blafr103/poolChlorinator/images/prototype1_circuit.png

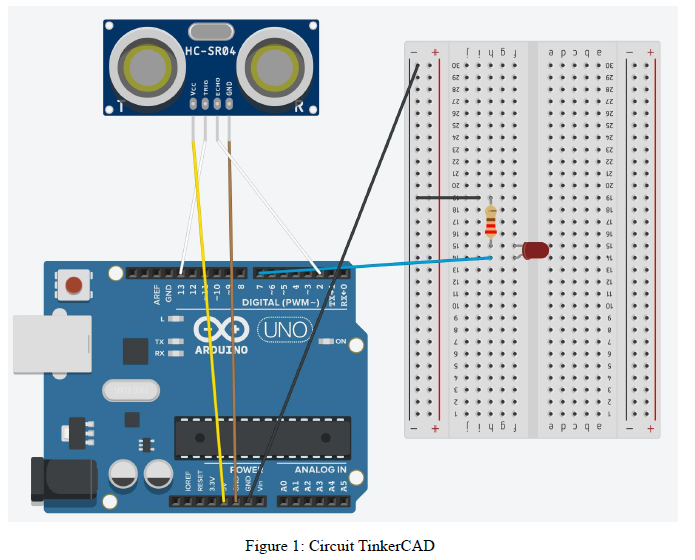
images/prototype1_circuit.png
