blafr103/poolChlorinator/images/prototype2_full.png

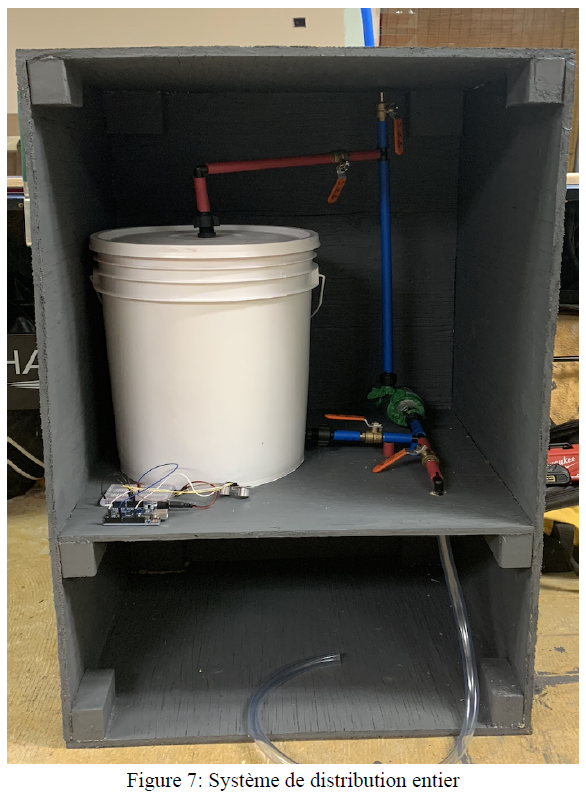
images/prototype2_full.png
