blafr103/poolChlorinator/images/code_flowchart.png

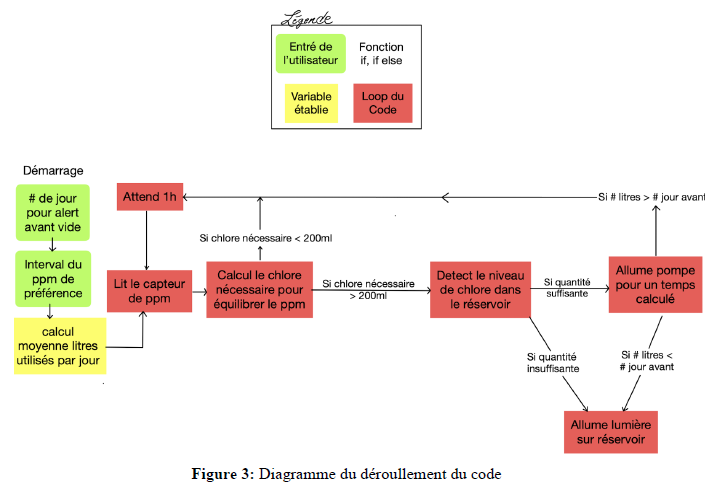
images/code_flowchart.png
