blafr103/poolChlorinator/docs/GNG2501 - Journée de conception.pdf

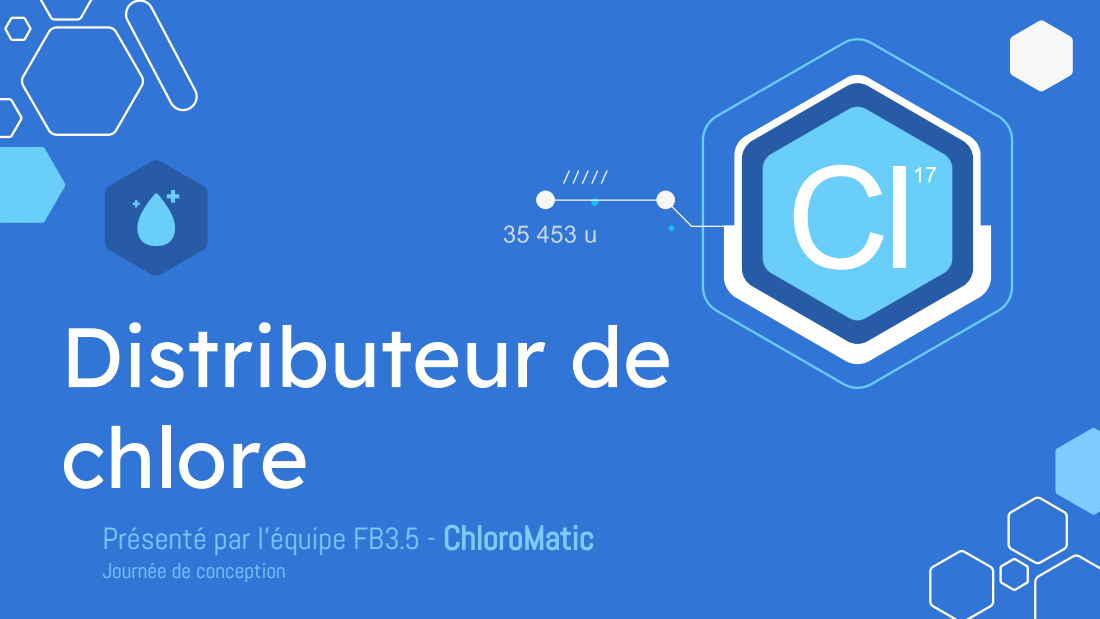
[picture p32: page 1]
Distributeur de chlore

Présenté par l’équipe FB3.5 - ChloroMatic
Journée de conception

# Agenda

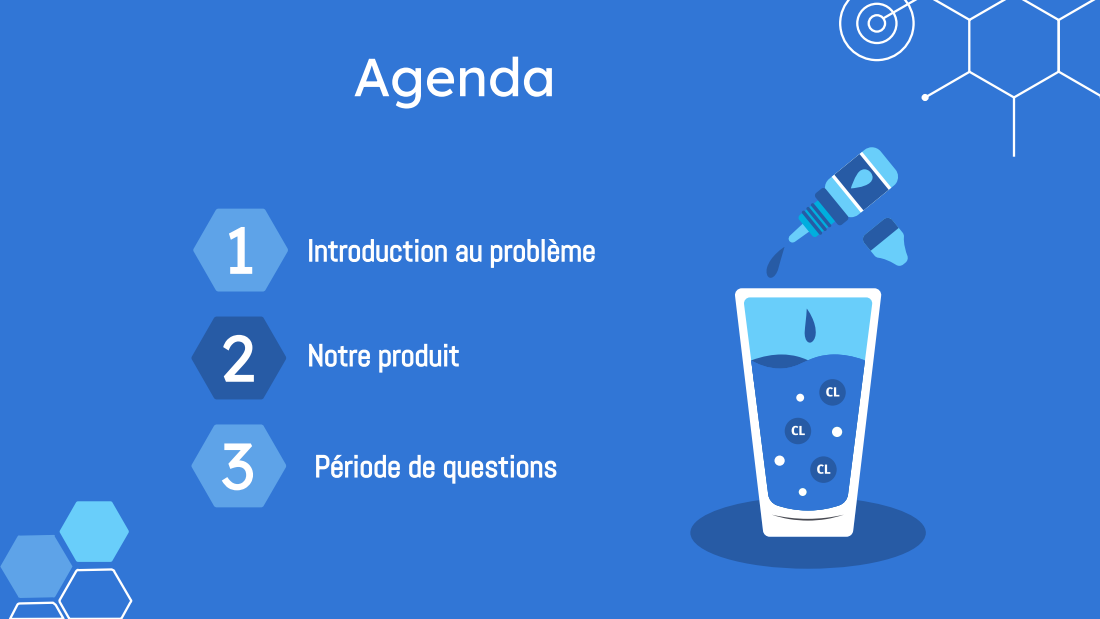
[picture p33: page 2]
Période de questions; Notre produit; Introduction au problème

# Introduction au problème

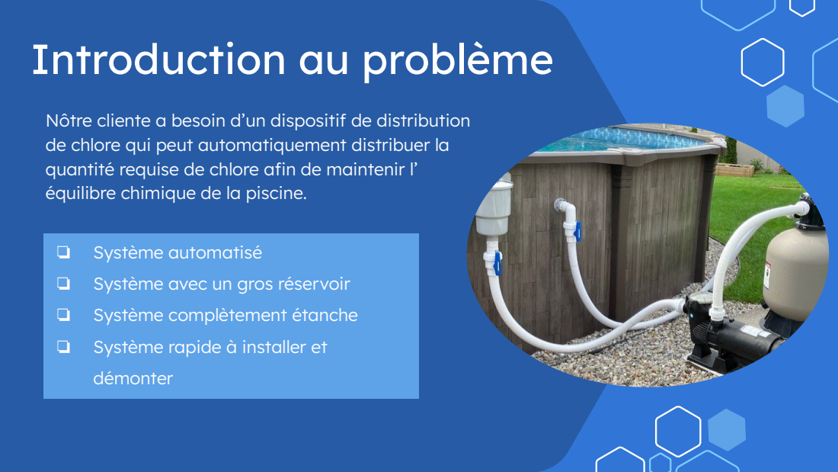
[picture p34: page 3]
Système automatisé; Système avec un gros réservoir; Système complètement étanche; Système rapide à installer et; démonter

Nôtre cliente a besoin d’un dispositif de distribution
de chlore qui peut automatiquement distribuer la
quantité requise de chlore afin de maintenir l’
équilibre chimique de la piscine.

# Conception et Évolution

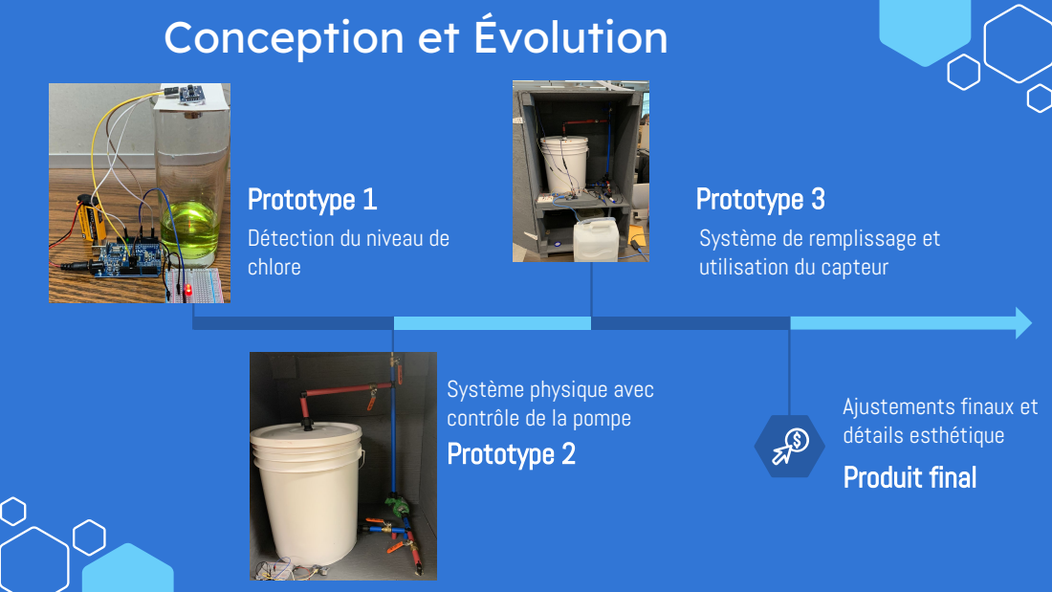
[picture p35: page 4]
contrôle de la pompe; Ajustements finaux et; détails esthétique; Prototype 1; Prototype 3; Produit final

Détection du niveau de
chlore

Système de remplissage et
utilisation du capteur

Système physique avec
Prototype 2

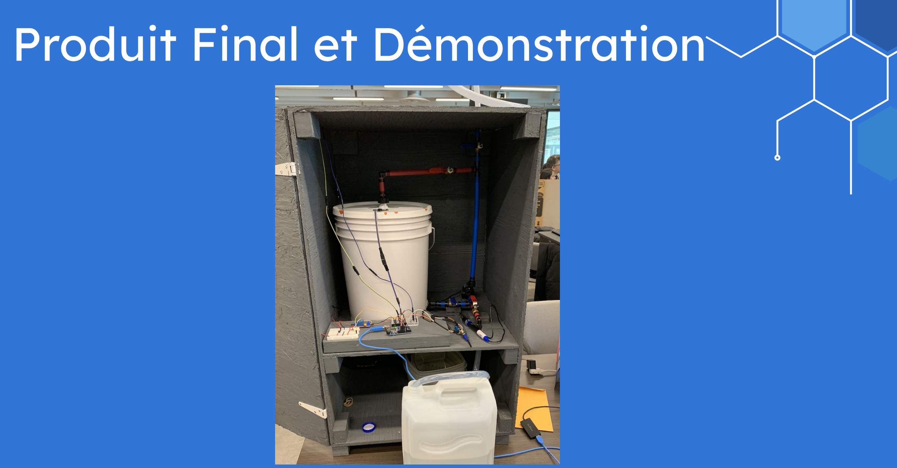
[picture p36: figure]
Produit Final et Démonstration
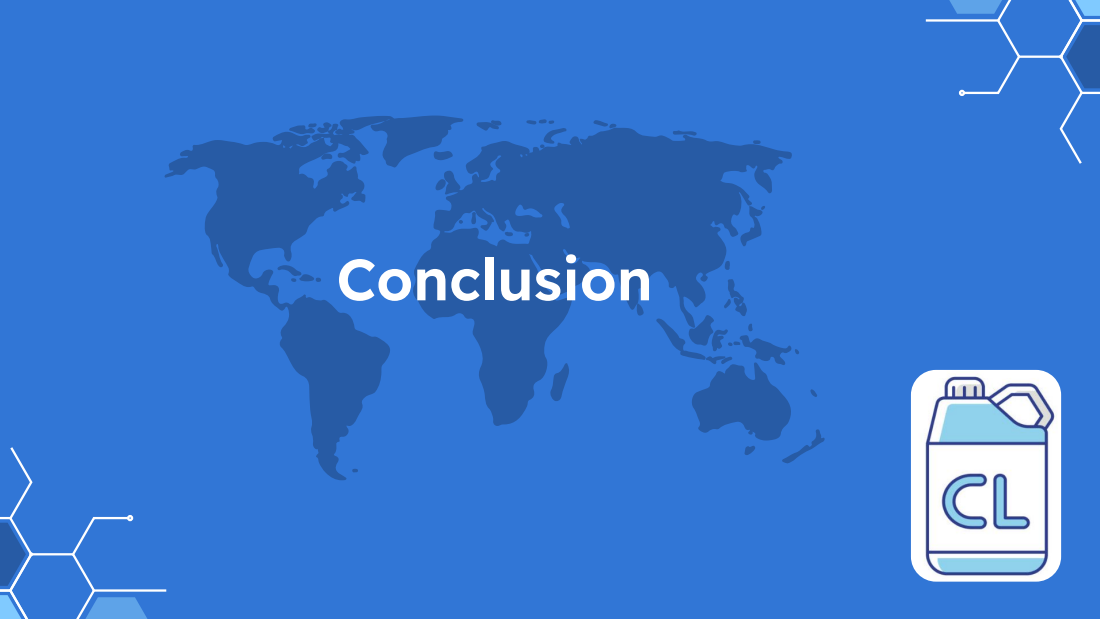
[picture p37: page 6]
Conclusion

## Pourquoi choisir ? Notre produit

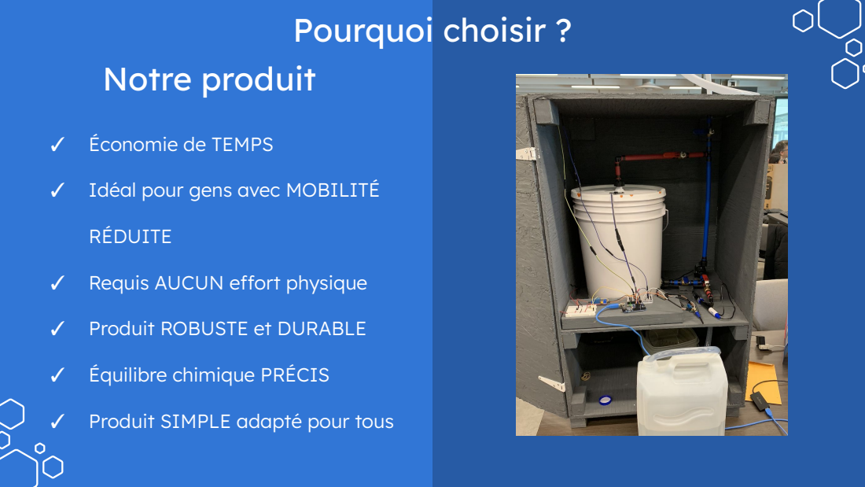
[picture p38: page 7]
RÉDUITE

✓ Économie de TEMPS

✓ Idéal pour gens avec MOBILITÉ

✓ Requis AUCUN effort physique

✓ Produit ROBUSTE et DURABLE

✓ Équilibre chimique PRÉCIS

✓ Produit SIMPLE adapté pour tous

## Pourquoi choisir ? Notre équipe

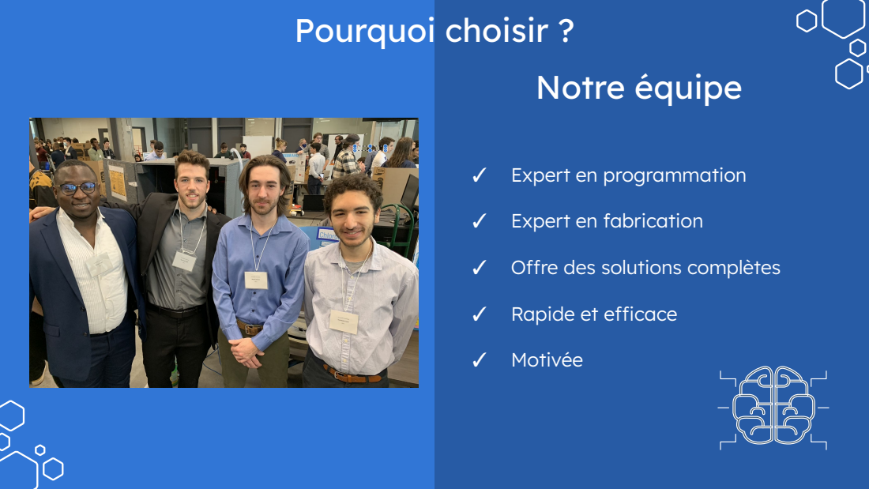
[picture p39: page 8]
✓ Motivée

✓ Expert en programmation

✓ Expert en fabrication

✓ Offre des solutions complètes

✓ Rapide et efficace

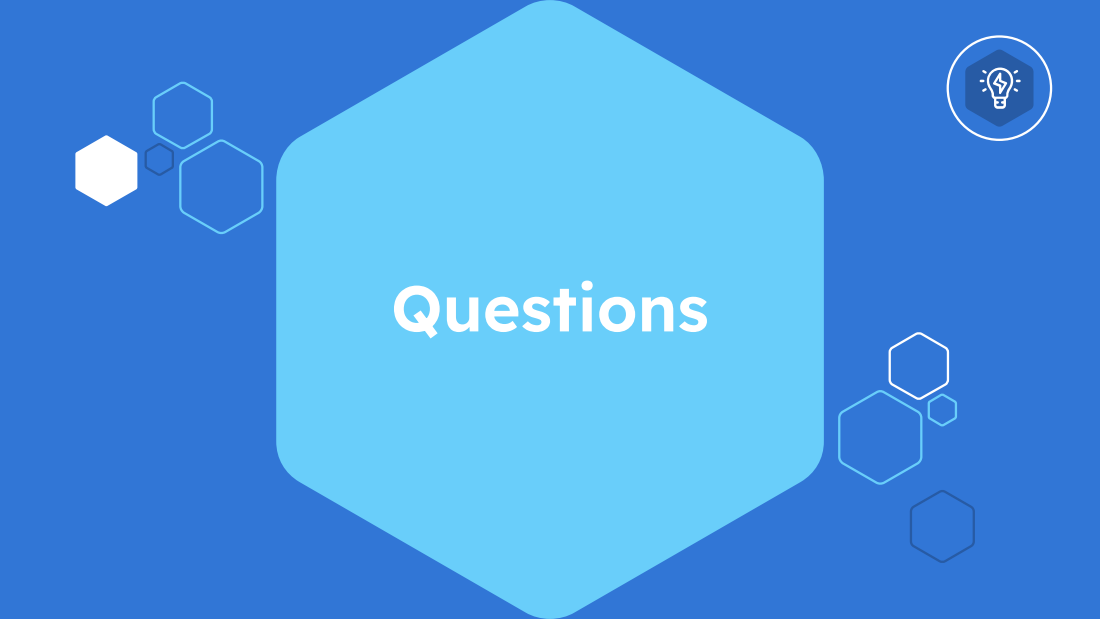
[picture p40: page 9]
Questions

# Besoins interprétés

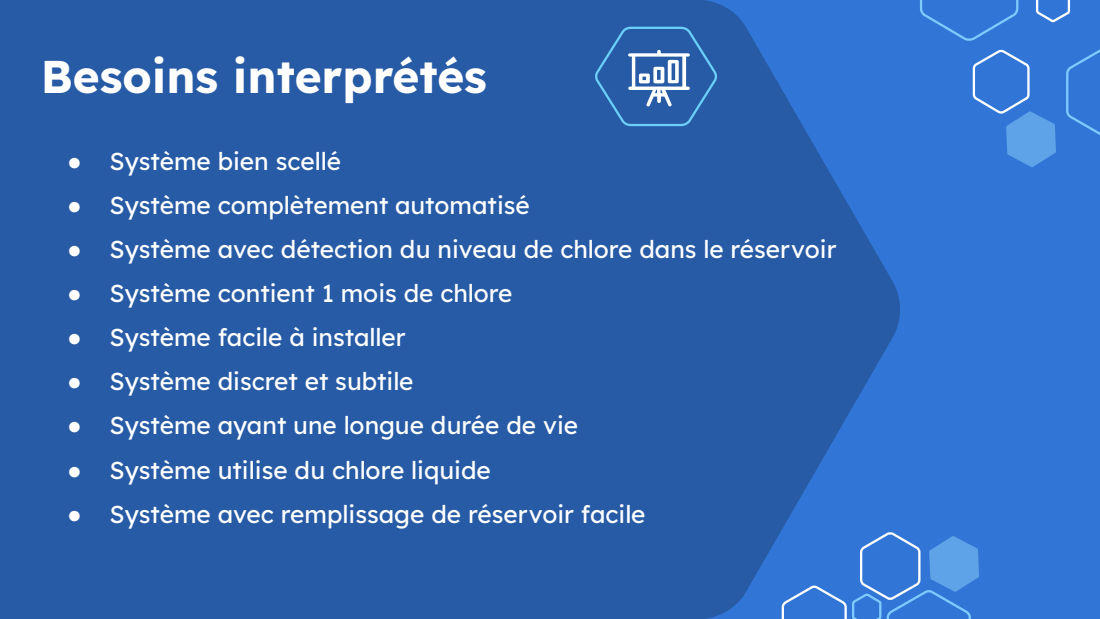
[picture p41: page 10]

● Système bien scellé
● Système complètement automatisé
● Système avec détection du niveau de chlore dans le réservoir
● Système contient 1 mois de chlore
● Système facile à installer
● Système discret et subtile
● Système ayant une longue durée de vie
● Système utilise du chlore liquide
● Système avec remplissage de réservoir facile

# Liste des Métriques

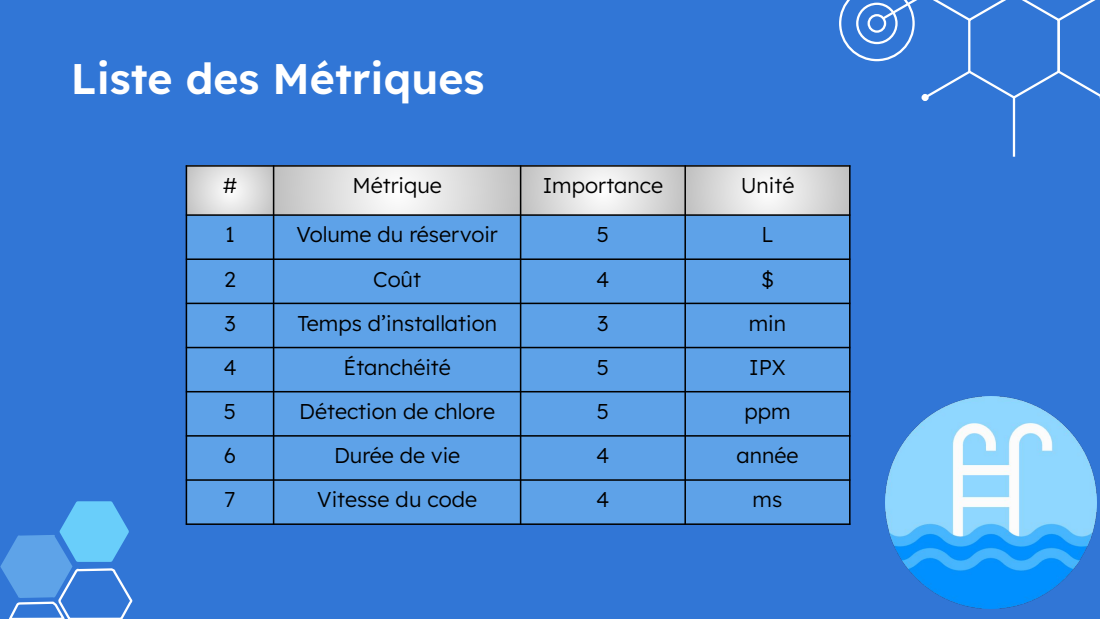
[picture p42: page 11]

# | Métrique | Importance | Unité
1 | Volume du réservoir | 5 | L
2 | Coût | 4 | $
3 | Temps d’installation | 3 | min
4 | Étanchéité | 5 | IPX
5 | Détection de chlore | 5 | ppm
6 | Durée de vie | 4 | année
7 | Vitesse du code | 4 | ms

# Étalonnage avec la concurrence

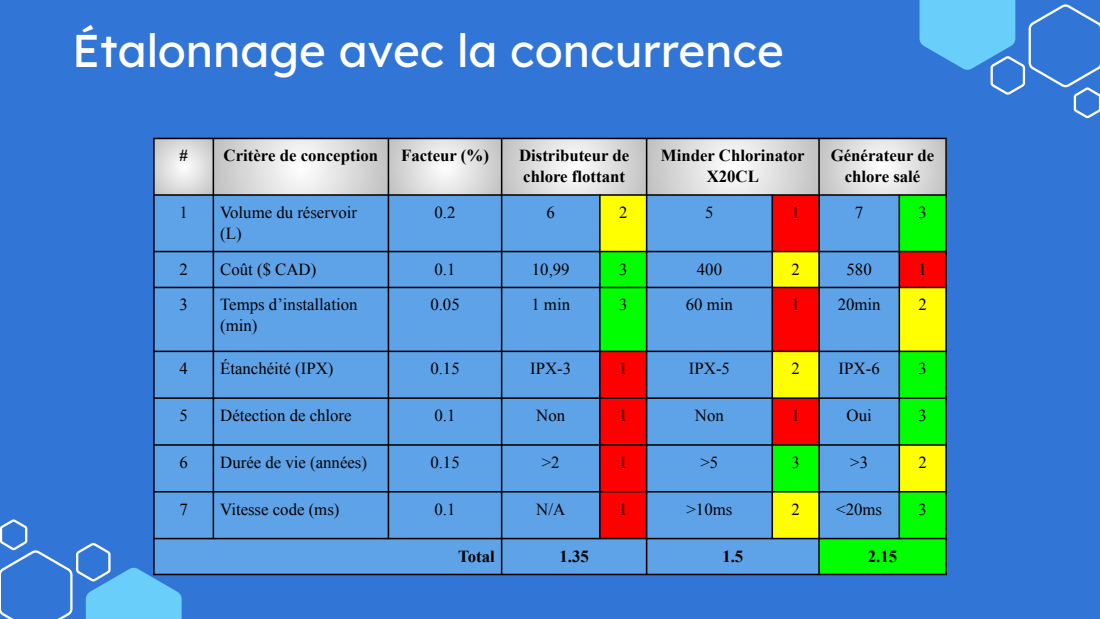
[picture p43: page 12]

# | Critère de conception | Facteur (%) | Distributeur de chlore flottant | Minder Chlorinator X20CL | Générateur de chlore salé

1 | Volume du réservoir (L) | 0.2 | 6 | 2 | 5 | 1 | 7 | 3

2 | Coût ($ CAD) | 0.1 | 10,99 | 3 | 400 | 2 | 580 | 1

3 | Temps d’installation (min) | 0.05 | 1 min | 3 | 60 min | 1 | 20min | 2

4 | Étanchéité (IPX) | 0.15 | IPX-3 | 1 | IPX-5 | 2 | IPX-6 | 3

5 | Détection de chlore | 0.1 | Non | 1 | Non | 1 | Oui | 3

6 | Durée de vie (années) | 0.15 | >2 | 1 | >5 | 3 | >3 | 2

7 | Vitesse code (ms) | 0.1 | N/A | 1 | >10ms | 2 | <20ms | 3

Total | | | 1.35 | | 1.5 | | 2.15

# Spécifications cibles

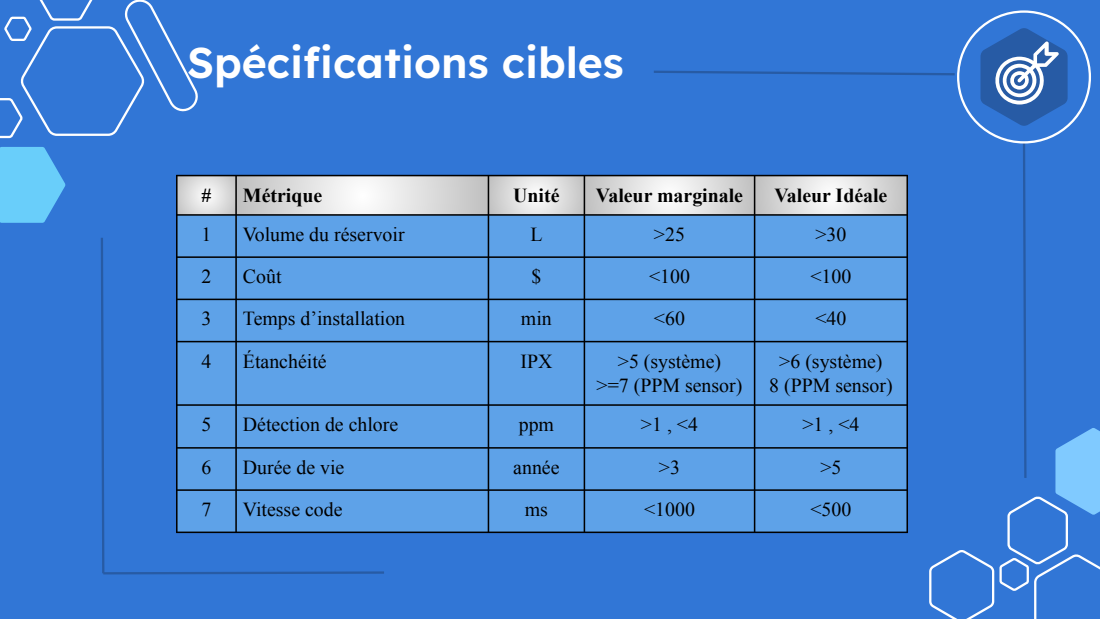
[picture p44: page 13]

# | Métrique | Unité | Valeur marginale | Valeur Idéale

1 | Volume du réservoir | L | >25 | >30

2 | Coût | $ | <100 | <100

3 | Temps d’installation | min | <60 | <40

4 | Étanchéité | IPX | >5 (système) >=7 (PPM sensor) | >6 (système) 8 (PPM sensor)

5 | Détection de chlore | ppm | >1 , <4 | >1 , <4

6 | Durée de vie | année | >3 | >5

7 | Vitesse code | ms | <1000 | <500

## Système logiciel

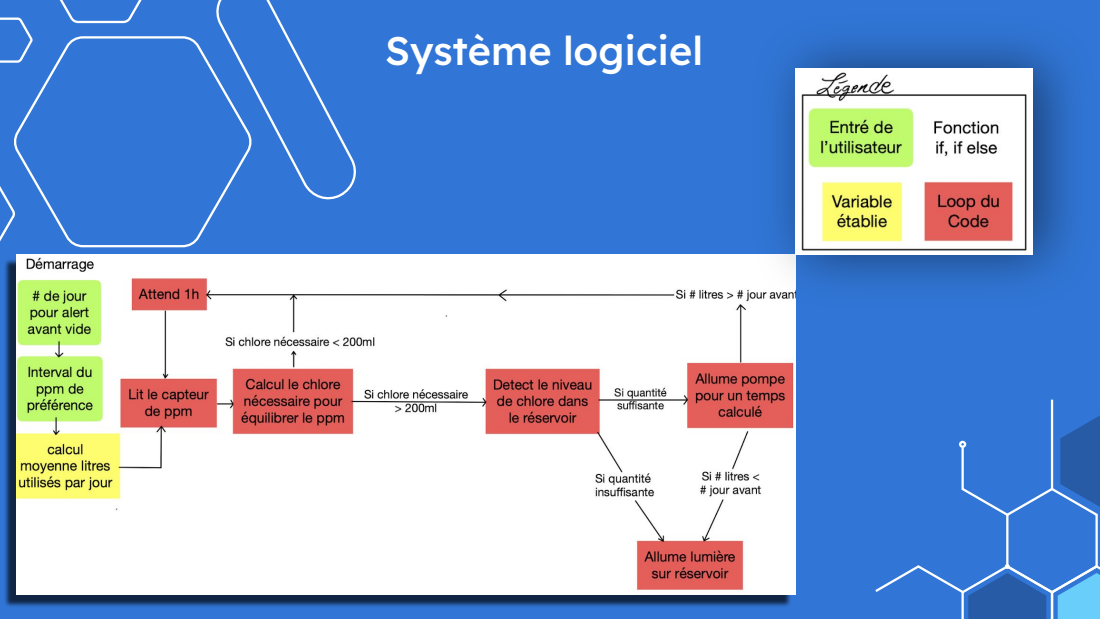
[picture p45: page 14]

# Rétroaction du client

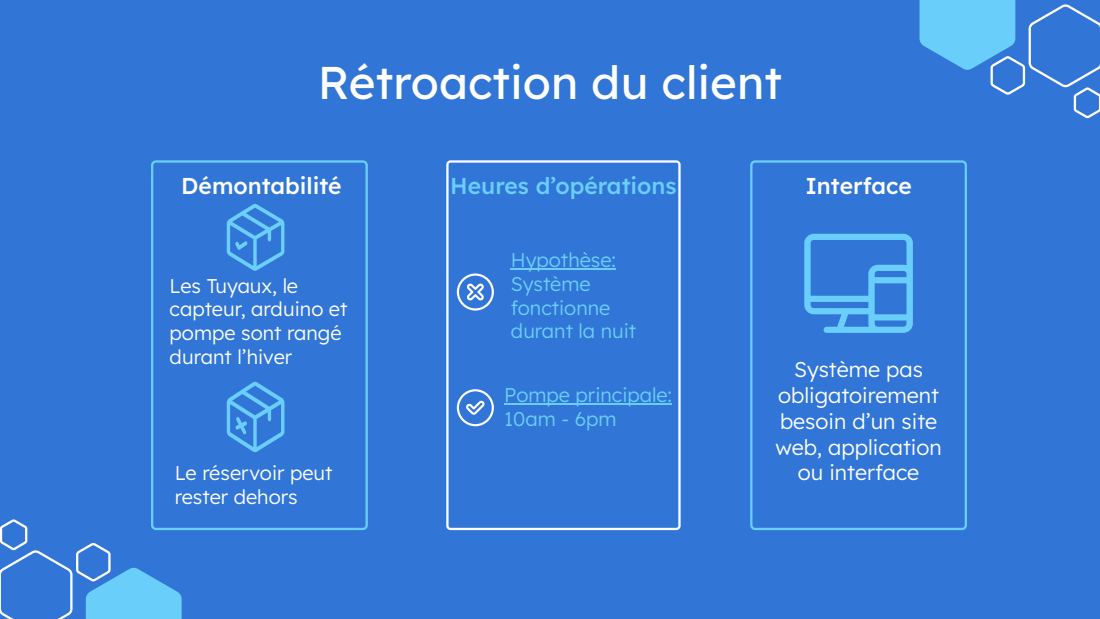
[picture p46: page 15]
Démontabilité; Heures d’opérations; Pompe principale: 10am - 6pm; Interface

Hypothèse:
Système
fonctionne
durant la nuit

Les Tuyaux, le
capteur, arduino et
pompe sont rangé
durant l’hiver

Système pas
obligatoirement
besoin d’un site
web, application
ou interface

Le réservoir peut
rester dehors
