blafr103/poolChlorinator/(commit log)

2023-03-12 Update sketch_feb26a.ino
    - rajouter une fonction main qui appelle la fonction loop() qui contient la boucle.
    - changer la boucle while et remplacer par Do...While dans la fonction main.
2023-03-13 Update sketch_feb26a.ino
    added pump function and relates variables and call
2023-03-13 Update sketch_feb26a.ino
    added light warning functions for pump activation
2023-03-23 Create pump_alone
2026-07-04 Fix timing/overflow bugs, fail-safe sensor reads, indicator logic, and de-block the wait
    Retrospective cleanup of the pool chlorination firmware. Corrects the timing bugs, makes bad sensor reads fail safe, aligns code with the manual and the Figure 5 program diagram, and removes the hour-long loop freeze. Overall formatting fixed as well.
    - dispenseDelay: was int (16-bit) holding 360000, which overflowed to ~32s AND was 6min not 1hr. Now unsigned long 3600000UL.
    - getCapteurPpm: removed erroneous extra /10 on the ADC-to-volt conversion (voltage was 10x too low, forcing a max dose every cycle).
    - Closed the boundary dead zone at exactly 200mL (< 0.2 / >= 0.2).
    - pingRes: switched to pin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
